joeljons/wr-start-trigger/bilder/låda1 side.jpeg

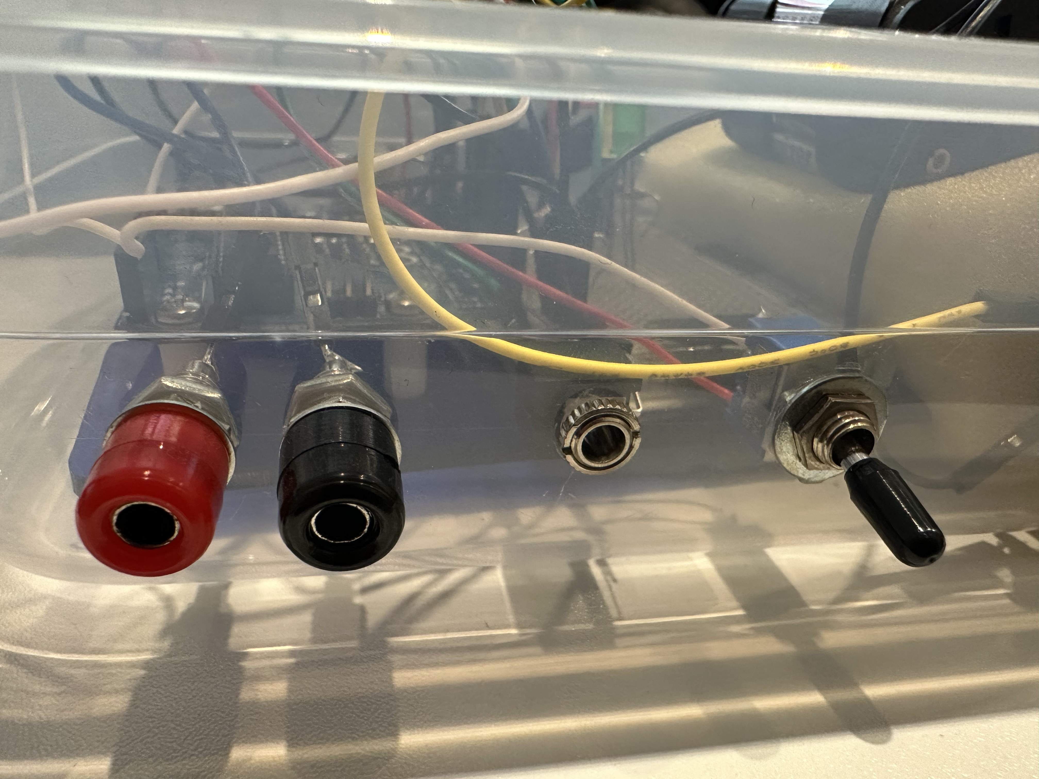
bilder/låda1 side.jpeg
