joeljons/wr-start-trigger/bilder/låda1 top.jpeg

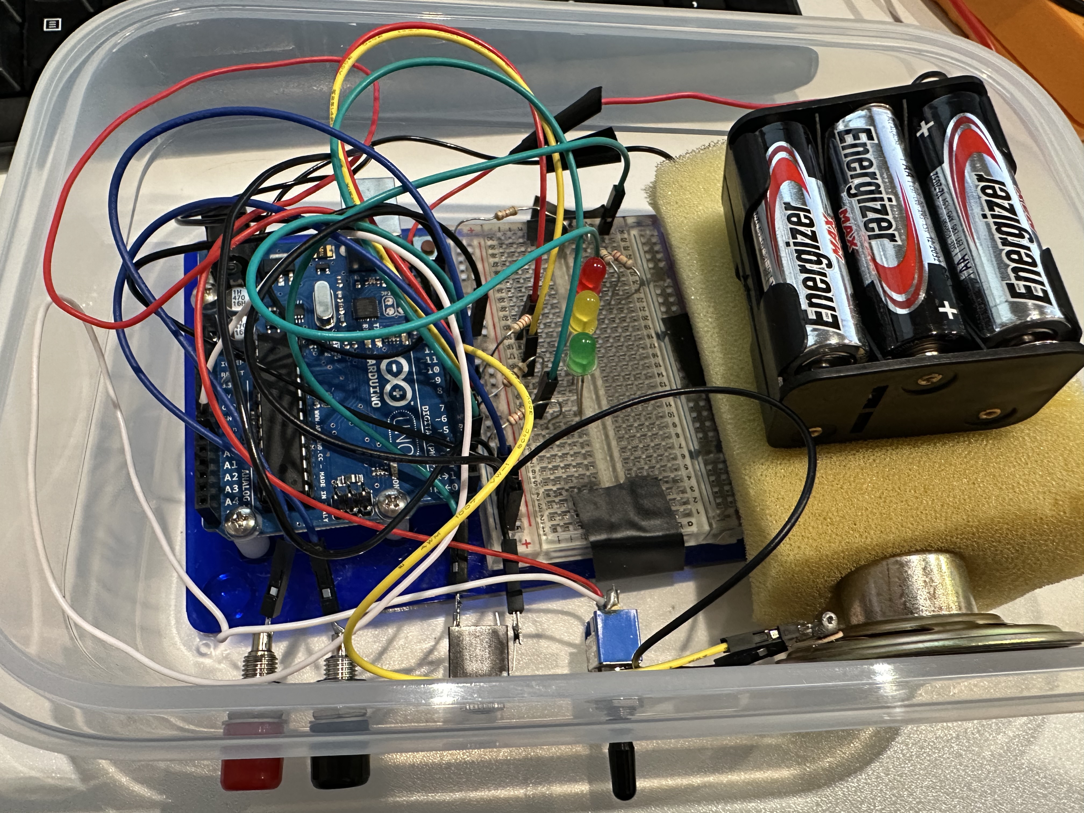
bilder/låda1 top.jpeg
