joeljons/wr-start-trigger/bilder/låda2 kretskort.jpeg

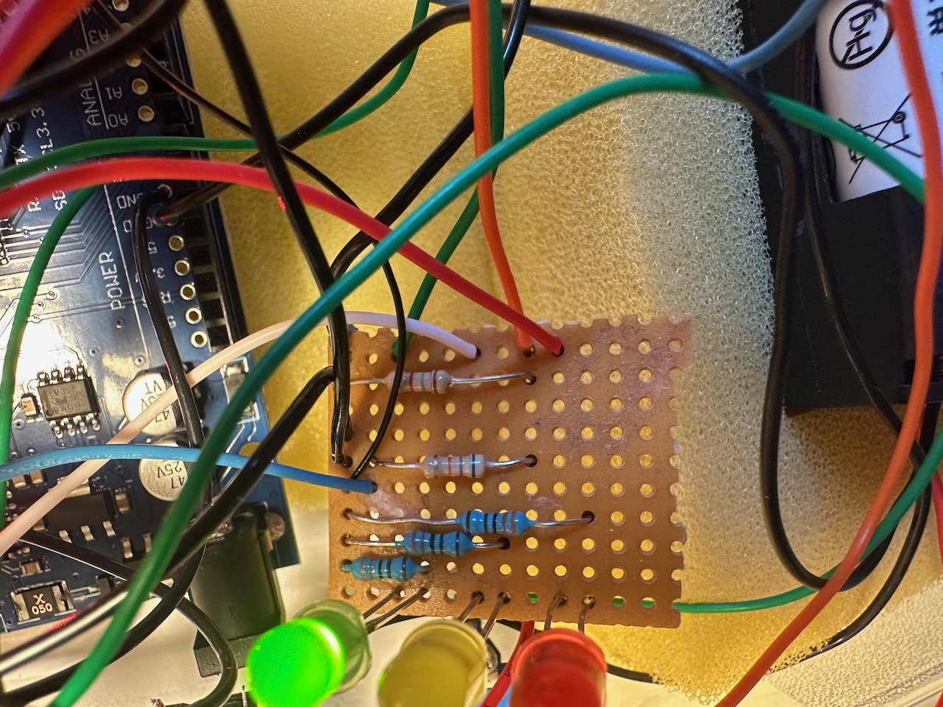
bilder/låda2 kretskort.jpeg
