joeljons/wr-start-trigger/bilder/låda2 side.jpeg

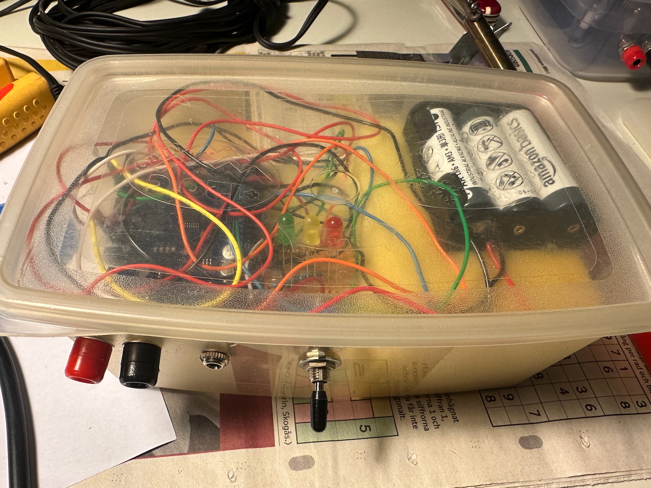
bilder/låda2 side.jpeg
