joeljons/wr-start-trigger/bilder/låda2 top.jpeg

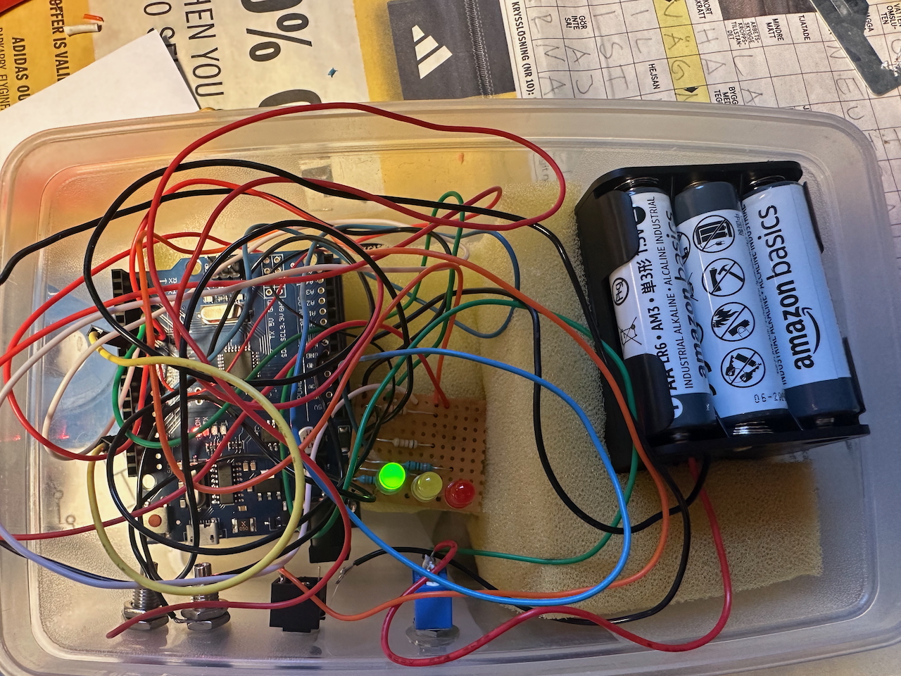
bilder/låda2 top.jpeg
