joeljons/wr-start-trigger/(commit log)

2025-05-20 Control cage open/closed default state by a cable from D6
2025-05-26 Remove analysis of an old cable
